YanRuiZhan/-/README.md

# 液压油缸试验台液压站设计
武汉理工大学 液压课程设计：液压油缸试验台液压站设计  仅供参考！
