YanRuiZhan/-/(list of files, cad)

Other CAD files:
002_液压动力站原理图.dwg
003_阀块_new.DWG
