YanRuiZhan/-/003_阀块_交付.pdf

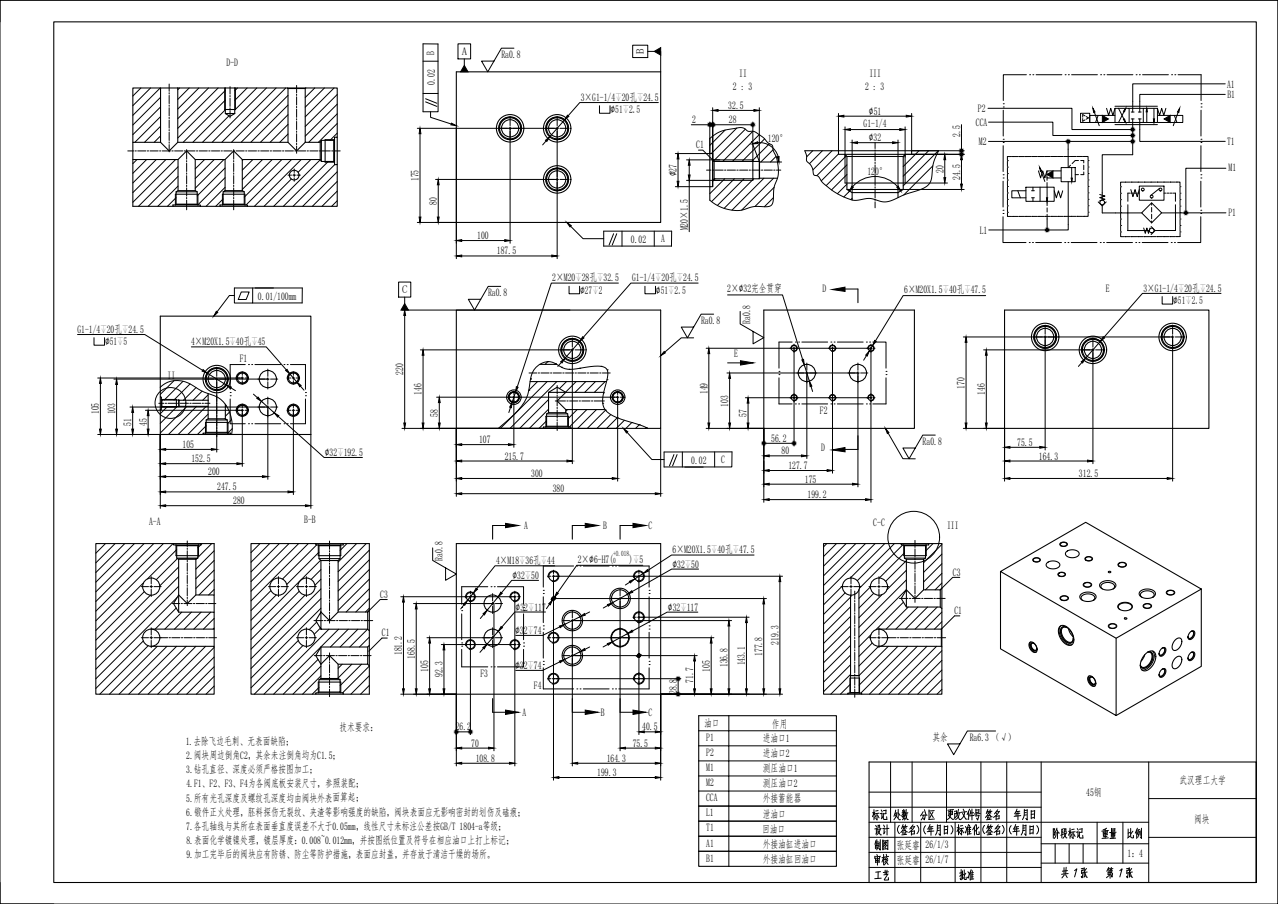
[picture p12: page 1]
III A-A

油口 | 作用
P1 | 进油口1
P2 | 进油口2

1.去除飞边毛刺、无表面缺陷；
2.阀块周边倒角C2，其余未注倒角均为C1.5；
3.钻孔直径、深度必须严格按图加工；
4.F1、F2、F3、F4为各阀底板安装尺寸，参照装配；
5.所有光孔深度及螺纹孔深度均由阀块外表面算起；
6.锻件正火处理，胚料探伤无裂纹、夹渣等影响强度的缺陷，阀块表面应无影响密封的划伤及磕痕；
7.各孔轴线与其所在表面垂直度误差不大于0.05mm，线性尺寸未标注公差按GB/T 1804-a等级；
8.表面化学镀镍处理，镀层厚度：0.008~0.012mm，并按图纸位置及符号在相应油口上打上标记；

M2 | 测压油口2
CCA | 外接蓄能器
L1 | 泄油口
T1 | 回油口
