YanRuiZhan/-/002_液压动力站原理图_交付.pdf

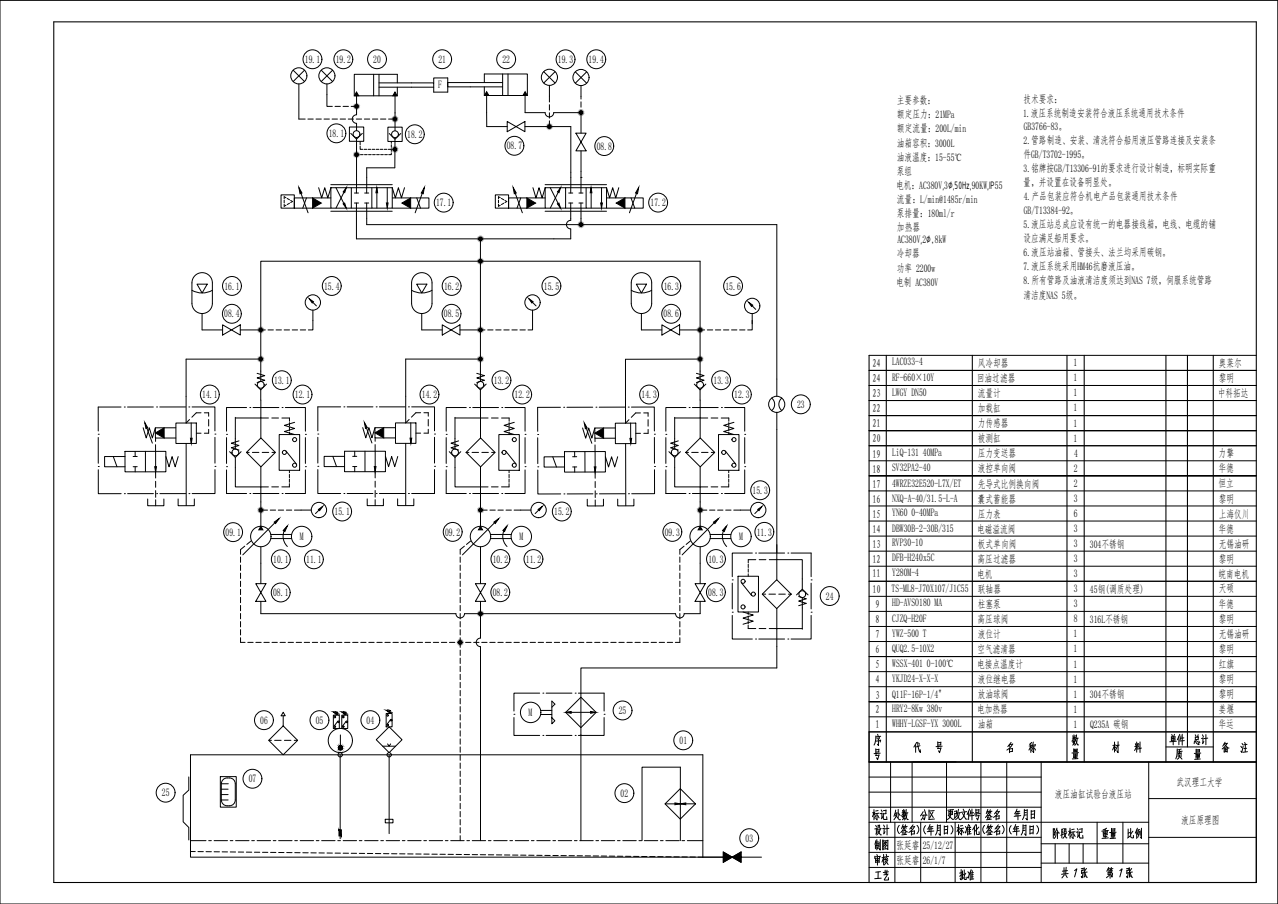
[picture p13: page 1]
8.所有管路及油液清洁度须达到NAS 7级，伺服系统管路 清洁度NAS 5级。

24 | LAC033-4 | 风冷却器 | 1 | | 奥莱尔
24 | RF-660×10Y | 回油过滤器 | 1 | | 黎明
23 | LWGY DN50 | 流量计 | 1 | | 中科拓达
22 | | 加载缸 | 1
21 | | 力传感器 | 1
20 | | 被测缸 | 1
19 | LiQ-131 40MPa | 压力变送器 | 4 | | 力擎
18 | SV32PA2-40 | 液控单向阀 | 2 | | 华德
17 | 4WRZE32E520-L7X/ET | 先导式比例换向阀 | 2 | | 恒立
16 | NXQ-A-40/31.5-L-A | 囊式蓄能器 | 3 | | 黎明
15 | YN60 0-40MPa | 压力表 | 6 | | 上海仪川
14 | DBW30B-2-30B/315 | 电磁溢流阀 | 3 | | 华德
13 | RVP30-10 | 板式单向阀 | 3 | 304不锈钢 | 无锡油研
12 | DFB-H240x5C | 高压过滤器 | 3 | | 黎明
11 | Y280M-4 | 电机 | 3 | | 皖南电机
10 | TS-ML8-J70X107/J1C55 | 联轴器 | 3 | 45钢(调质处理) | 天硕
9 | HD-AVSO180 MA | 柱塞泵 | 3 | | 华德
8 | CJZQ-H20F | 高压球阀 | 8 | 316L不锈钢 | 黎明
7 | YWZ-500 T | 液位计 | 1 | | 无锡油研
6 | QUQ2.5-10X2 | 空气滤清器 | 1 | | 黎明
5 | WSSX-401 0-100℃ | 电接点温度计 | 1 | | 红旗
4 | YKJD24-X-X-X | 液位继电器 | 1 | | 黎明
3 | Q11F-16P-1/4" | 放油球阀 | 1 | 304不锈钢 | 黎明
2 | HRY2-8Kw 380v | 电加热器 | 1 | | 姜堰
1 | WHHY-LGSF-YX 3000L | 油箱 | 1 | Q235A 碳钢 | 华运

张延睿 | 25/12/27
张延睿 26/1/7
